huai0216/Advanced-VLSI-System-Design/hw1/M16121077/src/CPU.sv

`include "pc.sv"
`include "IFID.sv"
`include "control.sv"
`include "regfile.sv"
`include "IDEX.sv"
`include "alu.sv"
`include "EXMEM.sv"
`include "MEMWB.sv"
`include "forwarding.sv"
`include "hazard.sv"

module CPU(
	input clk,
	input rst,
	input [31:0] inst,
	input [31:0] ddata,
	output logic [15:0] iaddr,
	output logic memwrite,
	output logic [15:0] daddr,
	//data memory
	output logic [31:0] datawrite,
	output logic [31:0] bit_enable
);


logic [15:0] pcnext, pcin;

logic [31:0] inst_out_id;
wire [3:0] aluopfromctrl;
wire [31:0] data1fromreg, data2fromreg;
logic [31:0] data1;
logic [31:0] data2;
wire [3:0] aluop;
logic [31:0] aluout, datapc, aluresult;

wire [31:0] writedata;
wire [31:0] writeddata;
wire memtoregctrl, memtoregex, memtoregmem, memtoreg;
wire [4:0] rdex, rdmem, rd;
logic [31:0] data2frommux;
wire [1:0] data2src, data2srcctrl;
wire memwritefromctrl;
logic [31:0] writedatareg;
logic [31:0] extendimm, immdata;
wire [2:0] datatypefromctrl;
wire [2:0] datatypeex;
wire [2:0] datatypemem;
logic [15:0] pcnextex;

logic pcsrc;
wire regwrite, regwritectrl, regwriteex, regwritemem;
wire [1:0] writetypectrl, writetype;
wire [15:0] pc_buffer, pcdata;
logic [1:0] forwarda, forwardb;
logic jumpctrl, jump,  jump_delay;
logic [2:0] comptype, comptypectrl;
wire [4:0] shamtdata;
logic branchctrl, branch, branch_check;
wire memreadctrl, memread;
logic [31:0] idata;
logic load_use_hazard, delay_hazard;
logic [31:0] pcimm;
wire auipc, auipcctrl;
wire [1:0] regwritedatctrl, regwritedat;
wire pcwritedatctrl, pcwritedat;
logic [63:0] instret, totalcycle;
logic floatop, floatopctrl, floatwbmem, floatwb, floatwbctrl, floatrd1ctrl, floatrd2ctrl,floatwbex, floatrd1, floatrd2;
logic rdinstretctrl, highctrl, rdinstret, high;
logic [31:0] csrdata;
logic [63:0] csr;
logic first;
logic [31:0] datafromalu;
logic [31:0] dmdata;
pc pc(
	.clk(clk),
	.rst(rst),
	.pcin(pcin),
	.load_use_hazard(load_use_hazard),
	.pcout(iaddr),
	.pc_buffer(pc_buffer)
);



	

	always_ff@(posedge clk or posedge rst)begin
		if(rst)begin
			instret <= 64'd0;
			totalcycle <= 64'd0;
			jump_delay <= 1'b0;
			first <= 1'b0;
		end else begin
			totalcycle <= totalcycle + 64'd1;
			jump_delay <= jump || (branch_check && branch);
			first <= 1'b1;
			if((branch_check && branch)||jump||jump_delay||load_use_hazard)
				instret <= instret;
			else
				instret <= instret + 64'd1;
			
		end
	end



	

	always_comb begin
		pcnext = iaddr + 16'd4;
	
		case(pcwritedat)
			1'b0 : datapc = pcimm;
			1'b1 : datapc = aluout;
		endcase
	end
	always_comb begin
		case(memtoreg)
			1'b0 : writedatareg = writeddata;
			1'b1 : writedatareg = writedata;
		endcase		
	end
	always_comb begin
		case(forwarda)
			2'b00 : data1 = data1fromreg;
			2'b01 : data1 = writedatareg;
			2'b10 : data1 = aluresult;
			default : data1 = 32'd0;
		endcase
	end
	always_comb begin
		case(forwardb)
			2'b00 : data2frommux = data2fromreg; //data2frommux;
			2'b01 : data2frommux = writedatareg;
			2'b10 : data2frommux = aluresult;
			default : data2frommux = 32'd0;
		endcase
	end
	always_comb begin
		case(data2src)
			2'd0 : data2 = data2frommux;
			2'd1 : data2 = immdata;
			2'd2 : data2 = {27'd0,shamtdata};
			default : data2 = 32'd0;
		endcase
	end
	always_comb begin
		case(comptype)
			3'd0 : branch_check = (data1 == data2) ? 1'b1 : 1'b0; //EQ
			3'd1 : branch_check = (data1 != data2) ? 1'b1 : 1'b0; //NE
			3'd2 : branch_check = ($signed(data1) < $signed(data2)) ? 1'b1 : 1'b0; //LT
			3'd3 : branch_check = ~(($signed(data1)< $signed(data2)) ? 1'b1 : 1'b0); //GE
			3'd4 : branch_check = (data1 < data2) ? 1'b1 : 1'b0; //LTU
			3'd5 : branch_check = ~((data1 < data2) ? 1'b1 : 1'b0); //GEU
			default : branch_check = 1'b0;
		endcase
	end
	always_comb begin
		if((branch_check && branch) || jump) 
			pcsrc = 1'b1;
		else 
			pcsrc = 1'b0;
	end
	always_comb begin
		pcin = (pcsrc)? datapc : pcnext;
	end
	always_comb begin
		if(jump || jump_delay || (branch_check && branch) ||(!first))begin
			idata = 32'h0000_0093;
		end else if(delay_hazard )begin
			idata = inst_out_id;
		end else begin
			idata = inst;
		end
	end
	always_comb begin
		if(auipc)
			pcimm = {immdata[31:12],12'd0} + {16'd0,pcdata};
		else
			pcimm = {16'd0,pcdata} + immdata;
	end
	always_comb begin
		if(rdinstret)
			csr = instret - 64'd2;
		else 
			csr = totalcycle - 64'd2;
		if(high) 
			csrdata = csr[63:32];
		else 
			csrdata = csr[31:0];
	end
	always_comb begin
		case(idata[6:0])
			7'b0100011: extendimm = {{20{idata[31]}},idata[31:25],idata[11:7]};
			7'b0010111: extendimm = {idata[31:12], {12{idata[31]}}};
			7'b1100011: extendimm = {{20{idata[31]}}, idata[7], idata[30:25], idata[11:8],1'b0};
			7'b0110111: extendimm = {idata[31:12]};
			7'b0100111: extendimm = {{20{idata[31]}}, idata[31:25],idata[11:7]};
			7'b1101111: extendimm = {{20{idata[31]}}, idata[19:12],idata[20],idata[30:21],1'b0};
			default : extendimm =  {{20{idata[31]}}, idata[31:20]};
		endcase
	end
	always_comb begin
		case(regwritedat)
			2'b00 : datafromalu = datapc;
			2'b01 : datafromalu = {immdata,12'd0};
			2'b10 : datafromalu = pcnextex;
			2'b11 : datafromalu = csrdata;
		endcase
	end
	always_comb begin
		daddr = datafromalu[15:0];
	end
	always_comb begin
		case(writetype) // 0 : full, 1 : byte, 2 : half
			2'b00 : begin
				datawrite = data2frommux;//  datawritemem
				bit_enable = 32'h0000_0000;
			end
			2'b01 : begin
				case(datafromalu[1:0])
					2'b00 : begin
						datawrite = data2frommux;
						bit_enable = 32'hffff_ff00;
					end
					2'b01 : begin
						datawrite = {16'd0, data2frommux[7:0], 8'd0};
						bit_enable = 32'hffff_00ff;
					end
					2'b10 : begin
						datawrite = {8'd0, data2frommux[7:0], 16'd0};
						bit_enable = 32'hff00_ffff; 
					end
					default : begin
						datawrite = {data2frommux[7:0], 24'd0};
						bit_enable = 32'h00ff_ffff;
					end
				endcase
			end
			2'b10 : begin
				case(datafromalu[1:0])
					2'b00 : begin
						datawrite = data2frommux;
						bit_enable = 32'hffff_0000;
					end
					2'b01 : begin
						datawrite = {8'd0, data2frommux[15:0], 8'd0};
						bit_enable = 32'hff00_00ff;
					end
					2'b10 : begin
						datawrite = {data2frommux[15:0], 16'd0};
						bit_enable = 32'h0000_ffff;
					end
					default : begin
						datawrite = 32'h0000_0000;
						bit_enable = 32'hffff_ffff;
					end
				endcase
			end
			default : begin
				datawrite = 32'h0000_0000;
				bit_enable = 32'hffff_ffff;
			end
		endcase
	end
	always_comb begin
		case(datatypemem)
			3'd1 : dmdata = {{24{ddata[7]}},ddata[7:0]}; //bs
			3'd0 : dmdata = ddata; //all
			3'd2 : dmdata = {{16{ddata[15]}}, ddata[15:0]}; //hs
			3'd3 : dmdata = {24'd0,ddata[7:0]}; //bu
			3'd4 : dmdata = {16'd0,ddata[15:0]}; //hu
			default : dmdata = 32'd0;
		endcase


	end










IFID ifid(
	//input
	.clk(clk),
	.rst(rst),
	.inst_in(inst),
	//output
	.inst_out(inst_out_id)
);

	
control control(
	.op(idata[6:0]),
	.funct3(idata[14:12]),
	.funct7(idata[31:25]),
	.instret(idata[21:20]),
	//output
	.aluop(aluopfromctrl),
	.memtoreg(memtoregctrl),
	.data2src(data2srcctrl),
	.memwrite(memwritefromctrl),
	.datatype(datatypefromctrl),
	.jump(jumpctrl),
	.regwrite(regwritectrl),
	.writetype(writetypectrl),
	.comptype(comptypectrl),
	.branch(branchctrl),
	.memread(memreadctrl),
	.auipc(auipcctrl),
	.regwritedat(regwritedatctrl),
	.pcwritedat(pcwritedatctrl),
	.floatop(floatopctrl),
	.floatrd2(floatrd2ctrl),
	.floatwb(floatwbctrl),
	.rdinstret(rdinstretctrl),
	.high(highctrl)
);



hazard hazard(
	.clk(clk),
	.rst(rst),
	.id_ex_memread(memread),
	.rs1(idata[19:15]),
	.rs2(idata[24:20]),
	.rd(rdex),
	//output
	.delay_hazard(delay_hazard),
	.load_use_hazard(load_use_hazard)
);


regfile regfile(
	// input
	.clk(clk),
	.rst(rst),
	.readreg1(idata[19:15]),
	.readreg2(idata[24:20]),
	.regwrite(regwrite),// temp
	.writereg(rd),//temp
	.writedata(writedatareg),//temp
	.load_use_hazard(load_use_hazard),
	.floatrd1(floatopctrl),
	.floatrd2(floatrd2ctrl),
	.floatwb(floatwb),
	// output
	.readdata1(data1fromreg),
	.readdata2(data2fromreg)
);




IDEX idex(
	.clk(clk),
	.rst(rst),
	.indata2src(data2srcctrl),
	.inaluop(aluopfromctrl),
	.inmemtoreg(memtoregctrl),
	.inrd(idata[11:7]), //idata
	.inmemwrite(memwritefromctrl),
	.indatatype(datatypefromctrl),
	.inpcnext(iaddr),
	.inregwrite(regwritectrl),
	.inwritetype(writetypectrl),
	.injump(jumpctrl),
	.jump(jump),
	.branch(branch),
	.branch_check(branch_check),
	.jump_delay(jump_delay),
	.inbranch(branchctrl),
	.inpc(pc_buffer),
	.inimme(extendimm),
	.inshamt(idata[24:20]),
	.inmemread(memreadctrl),
	.inregwritedat(regwritedatctrl),
	.inpcwritedat(pcwritedatctrl),
	.inauipc(auipcctrl),
	.infloatop(floatopctrl),
	.infloatwb(floatwbctrl),
	.load_use_hazard(load_use_hazard),
	.incomptype(comptypectrl),
	.inrdinstret(rdinstretctrl),
	.inhigh(highctrl),
	//output
	.outdata2src(data2src),
	.aluop(aluop),
	.outmemtoreg(memtoregex),
	.outrd(rdex),
	.outmemwrite(memwrite),
	.outdatatype(datatypeex),
	.outpcnext(pcnextex),
	.outregwrite(regwriteex),
	.outwritetype(writetype),
	.outjump(jump),
	.outbranch(branch),
	.outpc(pcdata),
	.outimme(immdata),
	.outshamt(shamtdata),
	.outmemread(memread),
	.outregwritedat(regwritedat),
	.outpcwritedat(pcwritedat),
	.outauipc(auipc),
	.outfloatop(floatop),
	.outfloatwb(floatwbex),
	.outcomptype(comptype),
	.outrdinstret(rdinstret),
	.outhigh(high)
);


alu alu(
	.aluop(aluop),
	.in1(data1),
	.in2(data2),
	.floatop(floatop),
	//output
	.aluout(aluout)
);



EXMEM exmem(
	.clk(clk),
	.rst(rst),
	.indata(datafromalu),
	.inmemtoreg(memtoregex),
	.inrd(rdex),
	.indatatype(datatypeex),
	.inregwrite(regwriteex),
	.infloatwb(floatwbex),
	//output
	.aludata(aluresult),
	.outmemtoreg(memtoregmem),
	.outrd(rdmem),
	.outdatatype(datatypemem),
	.outregwrite(regwritemem),
	.outfloatwb(floatwbmem)
);


MEMWB memwb(
	.clk(clk),
	.rst(rst),
	.indata(aluresult),
	.inmemtoreg(memtoregmem),
	.inrd(rdmem),
	.inddata(dmdata),
	.inregwrite(regwritemem),
	.infloatwb(floatwbmem),
	//output
	.outdata(writedata), //from alu
	.memtoreg(memtoreg),
	.outrd(rd),
	.outddata(writeddata),
	.outregwrite(regwrite),
	.outfloatwb(floatwb)
);


forwarding forwarding(
	//input
	.clk(clk),
	.rst(rst),
	.ex_mem_rd(rdex),
	.mem_wb_rd(rdmem),
	.id_ex_rs1(idata[19:15]),
	.id_ex_rs2(idata[24:20]),
	.regwritemem(regwriteex),
	.regwritewb(regwritemem),
	.floatwbmem(floatwbex),
	.floatwb(floatwbmem),
	.floatrd1(floatopctrl),
	.floatrd2(floatrd2ctrl),
	//output
	.forwardinga(forwarda),
	.forwardingb(forwardb)
);



endmodule
