huai0216/Advanced-VLSI-System-Design/hw4/M16121077/include/AXI_define.sv

//================================================
// Auther:      Chang-Wan-Yun (Claire)
// Filename:    AXI_define.svh
// Description: AXI defination
// Version:     1.0
//================================================
//`ifndef AXI_DEF
//`define AXI_DEF

`define AXI_ID_BITS 4
`define AXI_IDS_BITS 8
`define AXI_ADDR_BITS 32
`define AXI_LEN_BITS 32
`define AXI_SIZE_BITS 3
`define AXI_DATA_BITS 32
`define AXI_STRB_BITS 4
`define AXI_LEN_ONE 4'h0
`define AXI_SIZE_BYTE 3'b000
`define AXI_SIZE_HWORD 3'b001
`define AXI_SIZE_WORD 3'b010
`define AXI_BURST_INC 2'h1
`define AXI_STRB_WORD 4'b1111
`define AXI_STRB_HWORD 4'b0011
`define AXI_STRB_BYTE 4'b0001
`define AXI_RESP_OKAY 2'h0
`define AXI_RESP_SLVERR 2'h2
`define AXI_RESP_DECERR 2'h3



//`endif
