huai0216/Advanced-VLSI-System-Design/hw4/M16121077/src/fifo_mem.sv

module fifo_mem #(parameter DATA_SIZE = 8,
    parameter ADDR_SIZE = 4)(
    output [DATA_SIZE-1:0] rdata,        // Output data - data to be read
    input [DATA_SIZE-1:0] wdata,         // Input data - data to be written
    input [ADDR_SIZE-1:0] waddr, raddr,  // Write and read address
    input wclk_en, wfull, wclk          // Write clock enable, write full, write clock
    );

    localparam DEPTH = 1<<ADDR_SIZE;     // Depth of the FIFO memory
    reg [DATA_SIZE-1:0] mem [0:DEPTH-1];// Memory array

    assign rdata = mem[raddr];          // Read data

    always @(posedge wclk)
        if (wclk_en && !wfull) mem[waddr] <= wdata; // Write data

endmodule
