huai0216/Advanced-VLSI-System-Design/hw4/M16121077/src/two_ff_sync.sv

module two_ff_sync #(parameter SIZE = 4)( 
    output reg [SIZE-1:0] q2,   // Output of the second flip-flop
    input [SIZE-1:0] din,       // Input data
    input clk, rst_n            // Clock and reset
    );

    reg [SIZE-1:0] q1; // Output of the first flip-flop

    always @(posedge clk) begin
        if (!rst_n) 
            {q2, q1} <= 0;          // Reset the FIFO
        else 
            {q2, q1} <= {q1, din};  // Shift the data
    end 

endmodule
