huai0216/Advanced-VLSI-System-Design/hw4/M16121077/src/wptr_full.sv

module wptr_full #(parameter ADDR_SIZE = 4)(
    output reg wfull,                   // Full flag
    output [ADDR_SIZE-1:0] waddr,       // Write address
    output reg [ADDR_SIZE :0] wptr,     // Write pointer
    input [ADDR_SIZE :0] wq2_rptr,      // Read pointer (gray) - synchronised to write clock domain
    input winc, wclk, wrst_n            // Write increment, write-clock, and reset
    );

    reg [ADDR_SIZE:0] wbin;                     // Binary write pointer
    wire [ADDR_SIZE:0] wgray_next, wbin_next;   // Next write pointer in gray and binary code
    wire wfull_val;                             // Full flag value
    
    // Synchronous FIFO write pointer (gray code)
    always @(posedge wclk) begin
        if (!wrst_n)            // Reset the FIFO
            {wbin, wptr} <= 0;
        else 
            {wbin, wptr} <= {wbin_next, wgray_next}; // Shift the write pointer
    end

    assign waddr = wbin[ADDR_SIZE-1:0];             // Write address calculation from the write pointer
    assign wbin_next = wbin + (winc & ~wfull);       // Increment the write pointer if not full
    assign wgray_next = (wbin_next>>1) ^ wbin_next;    // Convert binary to gray code

    // Check if the FIFO is full
    //------------------------------------------------------------------
    // Simplified version of the three necessary full-tests:
    // assign wfull_val=((wg_next[ADDR_SIZE] !=wq2_rptr[ADDR_SIZE] ) &&
    // (wg_next[ADDR_SIZE-1] !=wq2_rptr[ADDR_SIZE-1]) &&
    // (wg_next[ADDR_SIZE-2:0]==wq2_rptr[ADDR_SIZE-2:0]));
    //------------------------------------------------------------------
    assign wfull_val = (wgray_next=={~wq2_rptr[ADDR_SIZE:ADDR_SIZE-1], wq2_rptr[ADDR_SIZE-2:0]});

    always @(posedge wclk) begin
        if (!wrst_n)            // Reset the full flag
            wfull <= 1'b0;
        else 
            wfull <= wfull_val; // Update the full flag
    end
endmodule
