huai0216/Advanced-VLSI-System-Design/hw3/M16121077/sim/prog1/main.c

#include <stdint.h>

#define MIP_MEIP (1 << 11) // External interrupt pending
#define MIP_MTIP (1 << 7)  // Timer interrupt pending
#define MIP 0x344

volatile unsigned int *WDT_addr = (int *) 0x10010000;
volatile unsigned int *dma_addr_boot = (int *) 0x10020000;




void timer_interrupt_handler(void) {
  asm("csrsi mstatus, 0x0"); // MIE of mstatus
  WDT_addr[0x40] = 0; // WDT_en
  asm("j _start");
}

void external_interrupt_handler(void) {
	volatile unsigned int *dma_addr_boot = (int *) 0x10020000;
	asm("csrsi mstatus, 0x0"); // MIE of mstatus
	dma_addr_boot[0x40] = 0; // disable DMA
}

void trap_handler(void) {
    uint32_t mip;
    asm volatile("csrr %0, %1" : "=r"(mip) : "i"(MIP));
	
    if ((mip & MIP_MTIP) >> 7) {
        timer_interrupt_handler();
    }

    if ((mip & MIP_MEIP) >> 11) {
        external_interrupt_handler();
    }
}


extern unsigned int array_size;
extern short array_addr;
const short* array = &array_addr;
extern short _test_start;
short* dest = &_test_start;

void bubbleSort(int16_t arr[], uint32_t size) {
    for (uint32_t i = 0; i < size - 1; i++) {
        for (uint32_t j = 0; j < size - i - 1; j++) {
            if (arr[j] > arr[j + 1]) {
                // Swap arr[j] and arr[j+1]
                int16_t temp = arr[j];
                arr[j] = arr[j + 1];
                arr[j + 1] = temp;
            }
        }
    }
}

int main() {
    // Copy the array to the destination
    for (uint32_t i = 0; i < array_size; i++) {
        dest[i] = array[i];
    }

    // Perform bubble sort on the dest array
    bubbleSort(dest, array_size);

    return 0;
}
