huai0216/Advanced-VLSI-System-Design/hw2/M16121077/sim/SRAM/SRAM_rtl.sv

//////////////////////////////////////////////////////////////////////
//          ██╗       ██████╗   ██╗  ██╗    ██████╗            		//
//          ██║       ██╔══█║   ██║  ██║    ██╔══█║            		//
//          ██║       ██████║   ███████║    ██████║            		//
//          ██║       ██╔═══╝   ██╔══██║    ██╔═══╝            		//
//          ███████╗  ██║  	    ██║  ██║    ██║  	           		//
//          ╚══════╝  ╚═╝  	    ╚═╝  ╚═╝    ╚═╝  	           		//
//                                                             		//
// 	2024 Advanced VLSI System Design, advisor: Lih-Yih, Chiou		//
//                                                             		//
//////////////////////////////////////////////////////////////////////
//                                                             		//
// 	Autor: 			TZUNG-JIN, TSAI (Leo)				  	   		//
//	Filename:		SRAM_rtl.sv                               		//
//	Description:	RTL model of 									//
//					TS1N16ADFPCLLLVTA512X45M4SWSHOD SRAM macro  	//
//					no timing information included, unsynthesizable	//
// 	Date:			2024/09/28								   		//
// 	Version:		1.0	    								   		//
//////////////////////////////////////////////////////////////////////
module TS1N16ADFPCLLLVTA512X45M4SWSHOD (
	SLP,
    DSLP,
    SD,
    PUDELAY,
    CLK, CEB, WEB,
    A, D,
    BWEB,
    RTSEL,
    WTSEL,
    Q);
	
	parameter Words 	= 16384;
	parameter Bits 		= 8;
	parameter Bytes	    = 4;
	parameter numRow = 512;
	parameter numCM = 32;	
	
	//=== IO Ports ===//

	// Normal Mode Input
	input SLP;
	input DSLP;
	input SD;
	input CLK;
	input CEB;
	input WEB;
	input [13:0] A;
	input [31:0] D;
	input [31:0] BWEB;


	// Data Output
	output logic [31:0] Q;
	output PUDELAY;


	// Test Mode
	input [1:0] RTSEL;
	input [1:0] WTSEL;
	
	
	logic	[Bytes*Bits-1:0] 	MEMORY [numRow][numCM];
	logic   [Bytes*Bits-1:0]    latched_DO;   
	
	assign PUDELAY = 1'b0;
	
	
always @(posedge CLK) begin
	if(~CEB) begin
		if (~WEB) begin
			if(~BWEB[0]) MEMORY[A/32][A%32][0] <= D[0];
			if(~BWEB[1]) MEMORY[A/32][A%32][1] <= D[1];
			if(~BWEB[2]) MEMORY[A/32][A%32][2] <= D[2];
			if(~BWEB[3]) MEMORY[A/32][A%32][3] <= D[3];
			if(~BWEB[4]) MEMORY[A/32][A%32][4] <= D[4];
			if(~BWEB[5]) MEMORY[A/32][A%32][5] <= D[5];
			if(~BWEB[6]) MEMORY[A/32][A%32][6] <= D[6];
			if(~BWEB[7]) MEMORY[A/32][A%32][7] <= D[7];
			if(~BWEB[8]) MEMORY[A/32][A%32][8] <= D[8];
			if(~BWEB[9]) MEMORY[A/32][A%32][9] <= D[9];
			if(~BWEB[10]) MEMORY[A/32][A%32][10] <= D[10];
			if(~BWEB[11]) MEMORY[A/32][A%32][11] <= D[11];
			if(~BWEB[12]) MEMORY[A/32][A%32][12] <= D[12];
			if(~BWEB[13]) MEMORY[A/32][A%32][13] <= D[13];
			if(~BWEB[14]) MEMORY[A/32][A%32][14] <= D[14];
			if(~BWEB[15]) MEMORY[A/32][A%32][15] <= D[15];
			if(~BWEB[16]) MEMORY[A/32][A%32][16] <= D[16];
			if(~BWEB[17]) MEMORY[A/32][A%32][17] <= D[17];
			if(~BWEB[18]) MEMORY[A/32][A%32][18] <= D[18];
			if(~BWEB[19]) MEMORY[A/32][A%32][19] <= D[19];
			if(~BWEB[20]) MEMORY[A/32][A%32][20] <= D[20];
			if(~BWEB[21]) MEMORY[A/32][A%32][21] <= D[21];
			if(~BWEB[22]) MEMORY[A/32][A%32][22] <= D[22];
			if(~BWEB[23]) MEMORY[A/32][A%32][23] <= D[23];
			if(~BWEB[24]) MEMORY[A/32][A%32][24] <= D[24];
			if(~BWEB[25]) MEMORY[A/32][A%32][25] <= D[25];
			if(~BWEB[26]) MEMORY[A/32][A%32][26] <= D[26];
			if(~BWEB[27]) MEMORY[A/32][A%32][27] <= D[27];
			if(~BWEB[28]) MEMORY[A/32][A%32][28] <= D[28];
			if(~BWEB[29]) MEMORY[A/32][A%32][29] <= D[29];
			if(~BWEB[30]) MEMORY[A/32][A%32][30] <= D[30];
			if(~BWEB[31]) MEMORY[A/32][A%32][31] <= D[31];
		end
		else begin
			latched_DO<= MEMORY[A/32][A%32];
		end
	end
end
	
always_comb begin
	Q = latched_DO;
end
	
endmodule
